glocklueng/I2C-LED/Document/Modification step 2.jpg

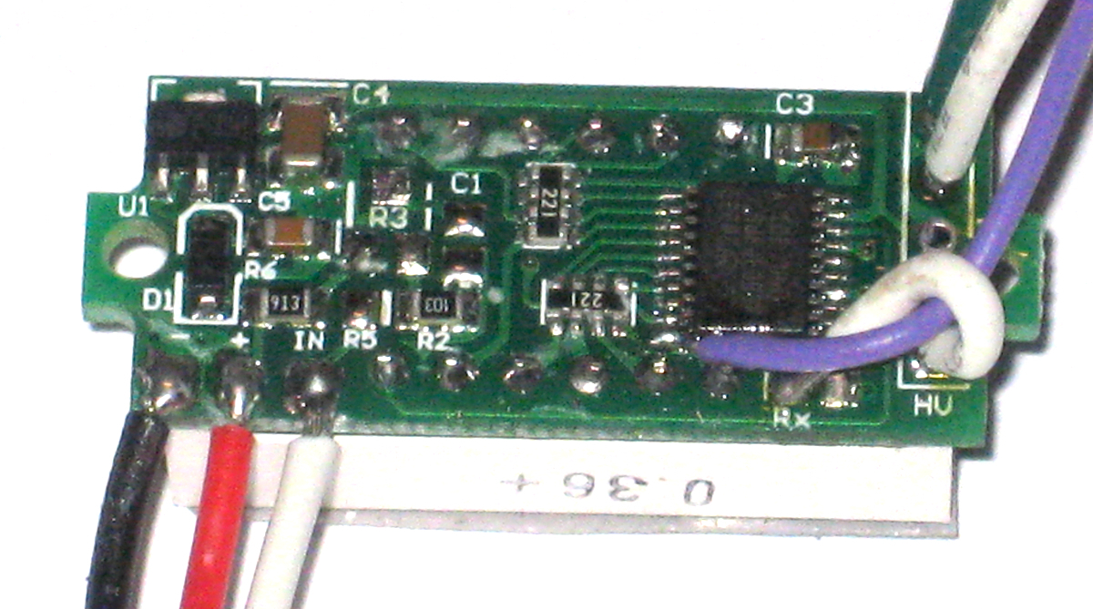
Document/Modification step 2.jpg
