glocklueng/I2C-LED/Document/Original Hardware (front, alternate).jpg

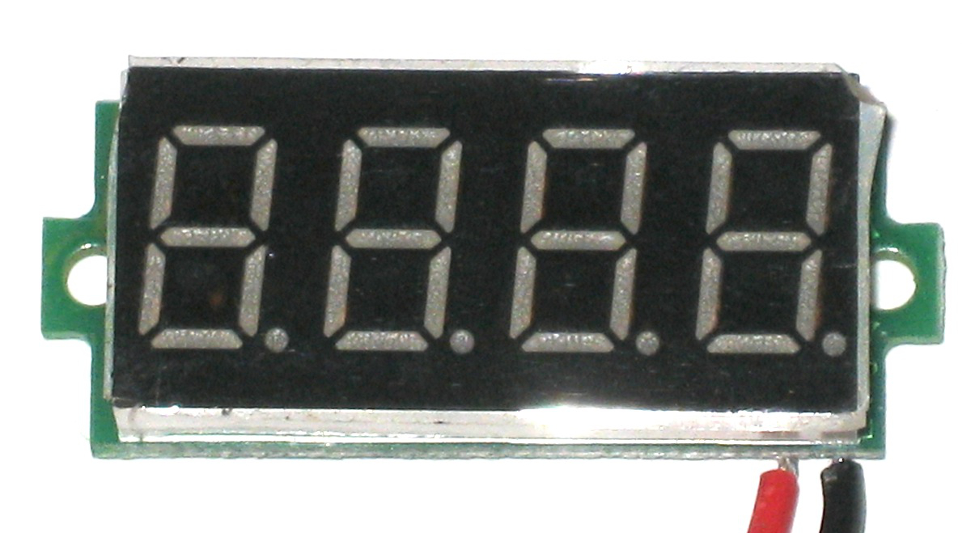
Document/Original Hardware (front, alternate).jpg
