glocklueng/I2C-LED/Document/Modified Hardware.jpg

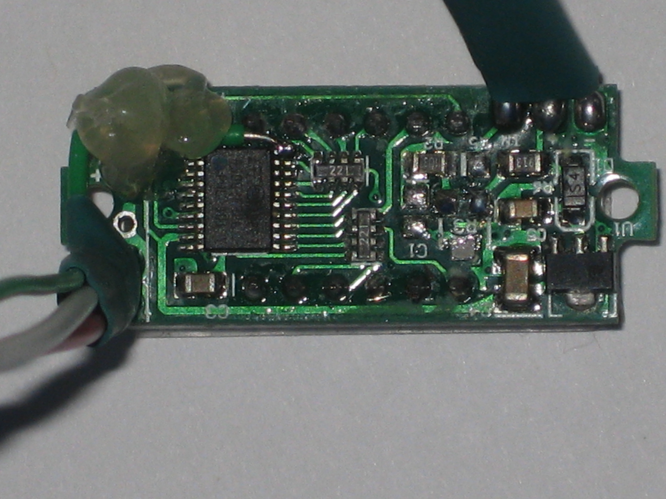
Document/Modified Hardware.jpg
