glocklueng/I2C-LED/Document/Original Hardware (back, type 1).jpg

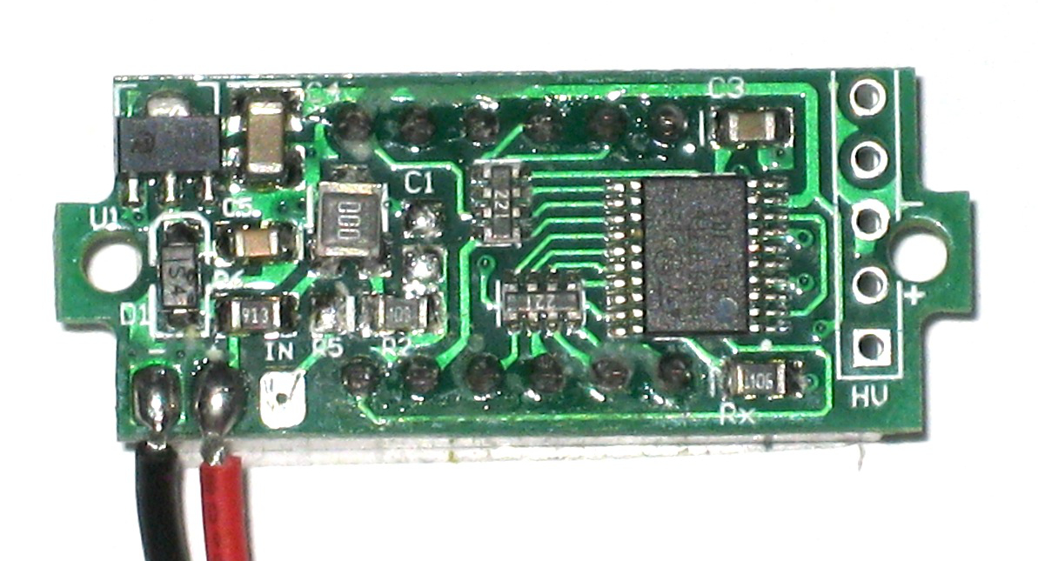
Document/Original Hardware (back, type 1).jpg
