glocklueng/I2C-LED/Document/Original Hardware (back, type 2).jpg

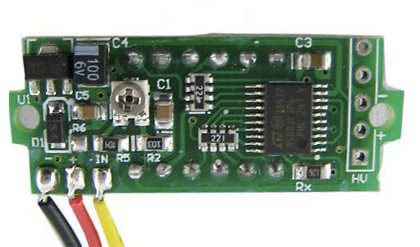
Document/Original Hardware (back, type 2).jpg
