glocklueng/I2C-LED/Document/Original Hardware (front).jpg

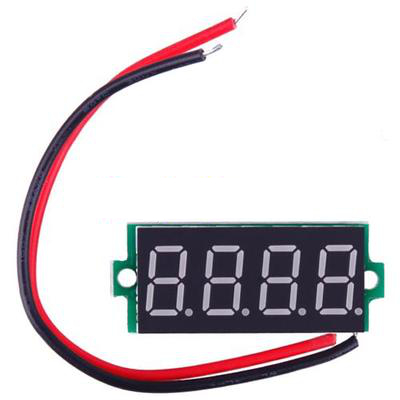
Document/Original Hardware (front).jpg
