glocklueng/I2C-LED/Document/Programming with STM8S discovery.jpg

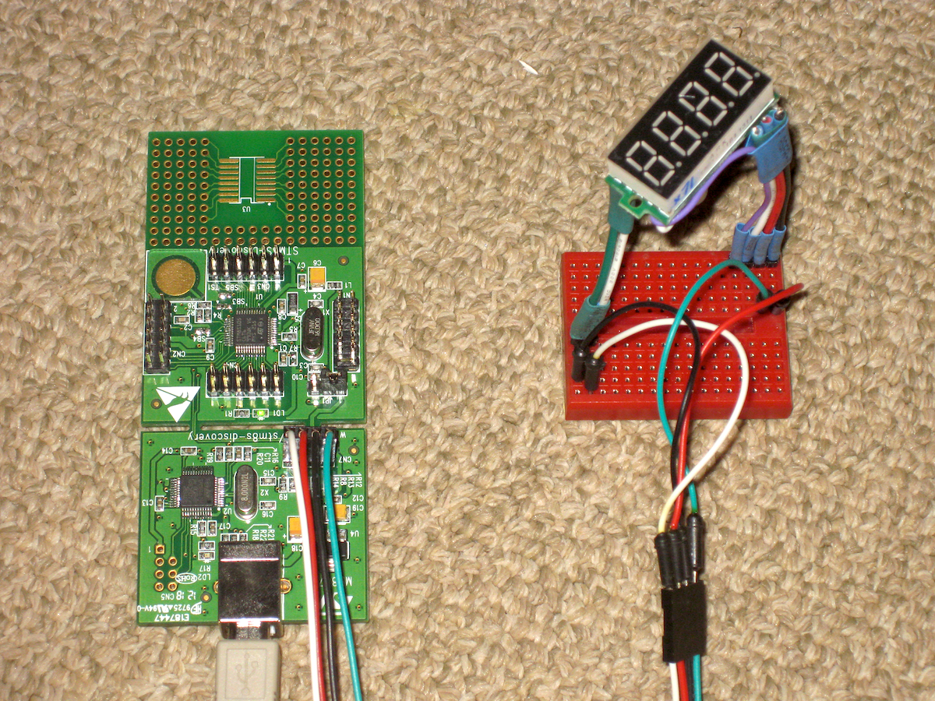
Document/Programming with STM8S discovery.jpg
