glocklueng/I2C-LED/Hardware/voltmeter-hack.png

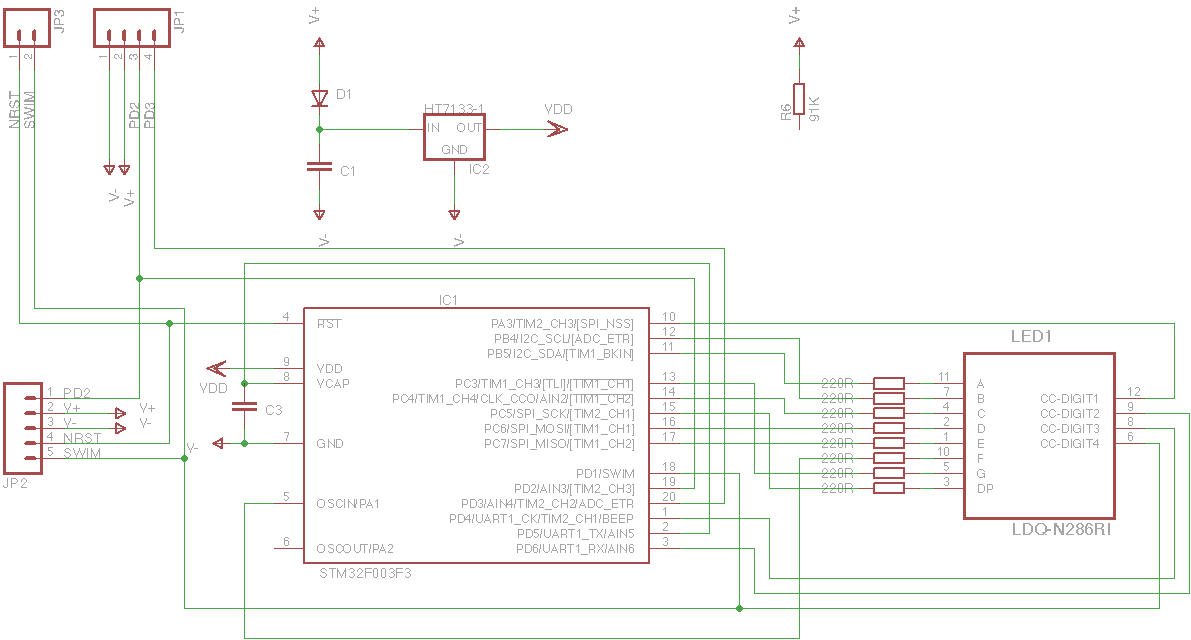
Hardware/voltmeter-hack.png
