glocklueng/I2C-LED/Document/Modification step 1.jpg

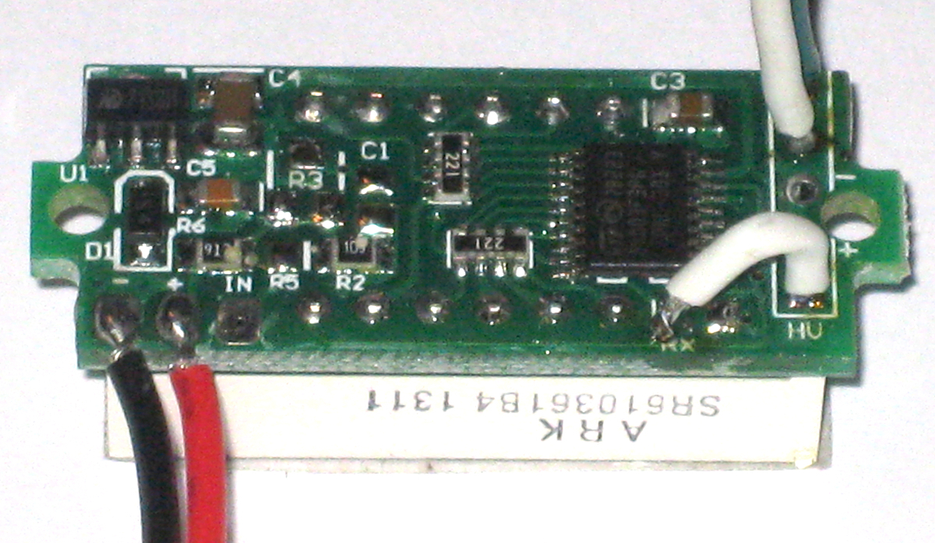
Document/Modification step 1.jpg
