glocklueng/I2C-LED/Document/Modification step 3.jpg

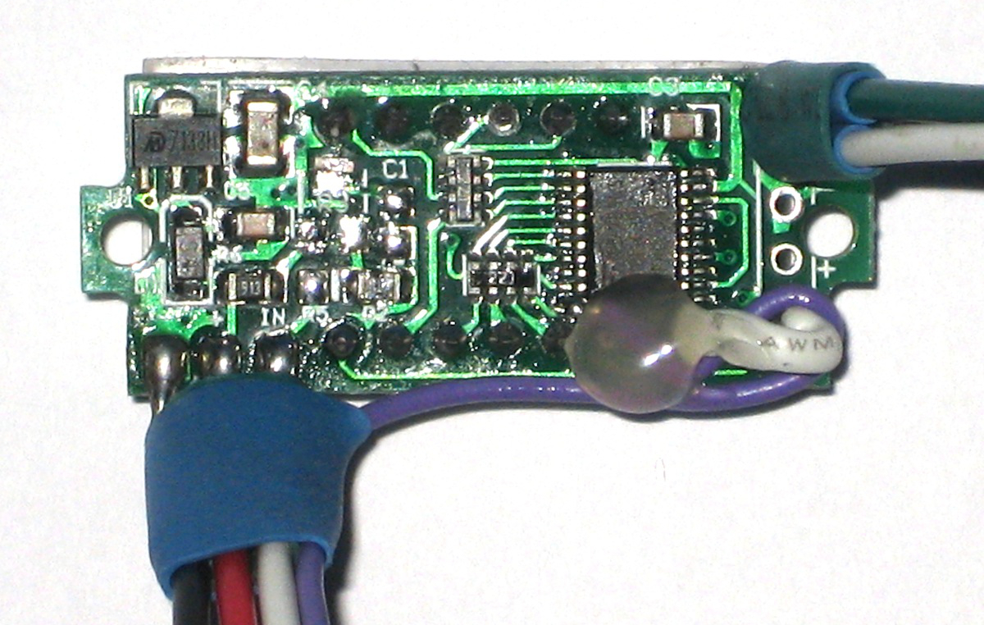
Document/Modification step 3.jpg
