glocklueng/I2C-LED/Document/Arduino Uno running sevenseg_test.ino with multiplexed displays.jpg

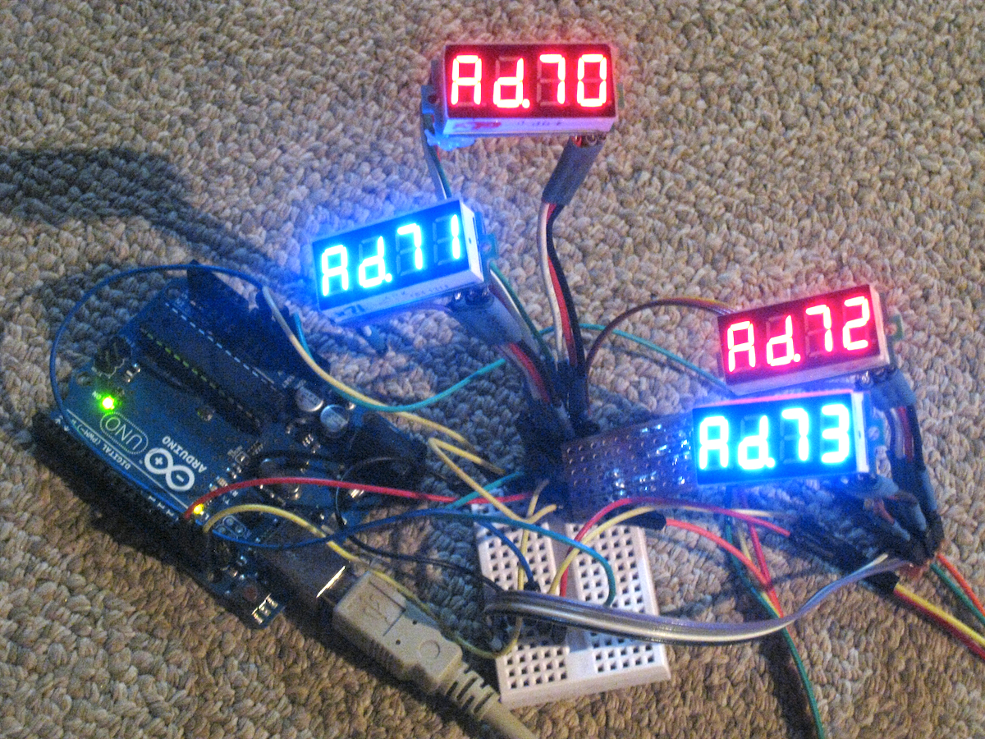
Document/Arduino Uno running sevenseg_test.ino with multiplexed displays.jpg
