glocklueng/I2C-LED/Hardware/voltmeter-hack.sch

## EAGLE design Hardware/voltmeter-hack.sch (2013-09-17)

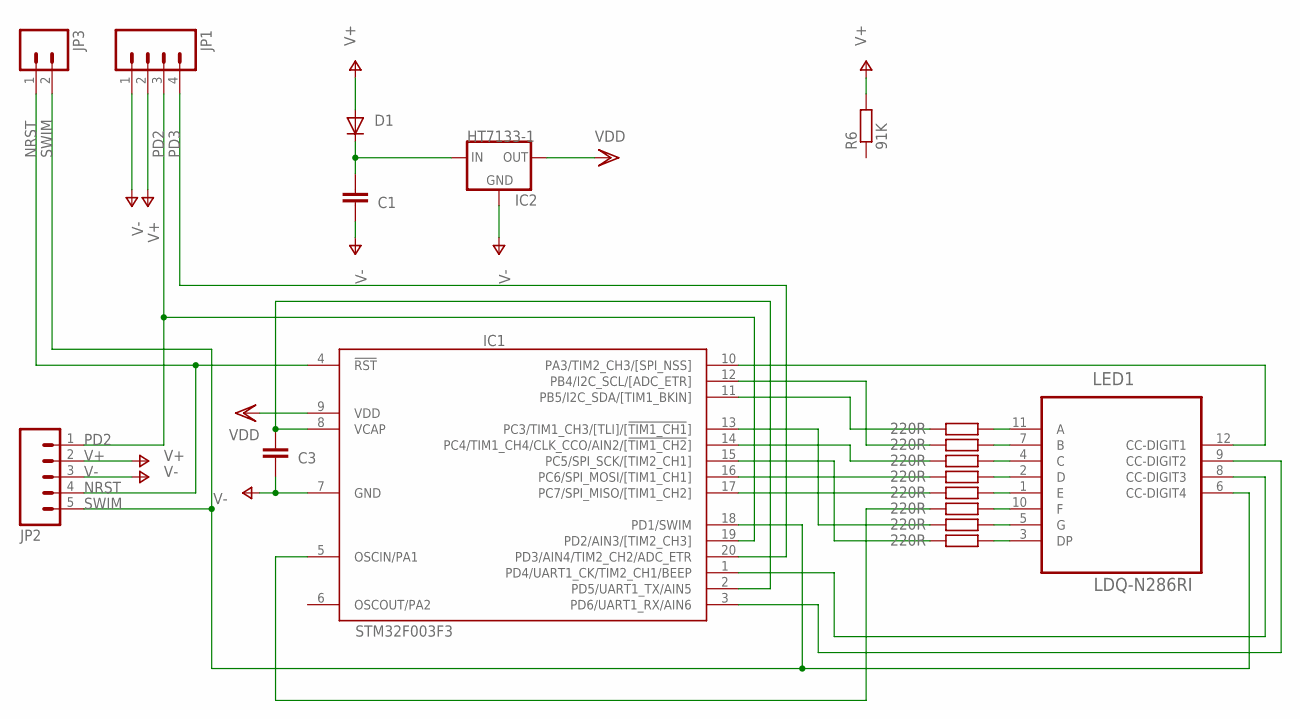
[picture p12: schematic voltmeter-hack.sch]

Parts:
C1, C3: C-EUC0603; C0603
D1: DIODE-SOD-123; SOD-123
IC1: STM32F003F3; TSSOP20
IC2: HT7133-1; SOT89R
JP1: M04PTH; 1X04
JP2: M05PTH; 1X05
JP3: M02PTH; 1X02
LED1: LDQ-N286RI; LUMEX_LDQ-N286RI
R1, R2, R4, R5, R7, R8, R13, R16: 220R; R0603
R6: 91K; R0603

Connections:
unnamed: C1.2, D1.C, IC2.2 (IN)
unnamed: C3.2, IC1.2 (PD5/UART1_TX/AIN5), IC1.8 (VCAP)
unnamed: IC1.10 (PA3/TIM2_CH3/[SPI_NSS]), LED1.12 (CC-DIGIT1)
unnamed: IC1.1 (PD4/UART1_CK/TIM2_CH1/BEEP), LED1.8 (CC-DIGIT3)
unnamed: IC1.3 (PD6/UART1_RX/AIN6), LED1.9 (CC-DIGIT2)
unnamed: LED1.11 (A), R1.2
unnamed: LED1.7 (B), R2.2
unnamed: LED1.4 (C), R13.2
unnamed: LED1.2 (D), R4.2
unnamed: LED1.1 (E), R5.2
unnamed: LED1.10 (F), R16.2
unnamed: LED1.5 (G), R7.2
unnamed: LED1.3 (DP), R8.2
unnamed: IC1.17 (PC7/SPI_MISO/[TIM1_CH2]), R5.1
unnamed: IC1.16 (PC6/SPI_MOSI/[TIM1_CH1]), R4.1
unnamed: IC1.15 (PC5/SPI_SCK/[TIM2_CH1]), R8.1
unnamed: IC1.14 (PC4/TIM1_CH4/CLK_CCO/AIN2/[!TIM1_CH2!]), R13.1
unnamed: IC1.13 (PC3/TIM1_CH3/[TLI]/[!TIM1_CH1!]), R7.1
unnamed: IC1.12 (PB4/I2C_SCL/[ADC_ETR]), R2.1
unnamed: IC1.11 (PB5/I2C_SDA/[TIM1_BKIN]), R1.1
unnamed: IC1.5 (OSCIN/PA1), R16.1
NRST: IC1.4 (!RST), JP2.4, JP3.1
PD2: IC1.19 (PD2/AIN3/[TIM2_CH3]), JP1.3, JP2.1
PD3: IC1.20 (PD3/AIN4/TIM2_CH2/ADC_ETR), JP1.4
SWIM: IC1.18 (PD1/SWIM), JP2.5, JP3.2, LED1.6 (CC-DIGIT4)
V+: D1.A, JP1.2, JP2.2, R6.2
V-: C1.1, C3.1, IC1.7 (GND), IC2.1 (GND), JP1.1, JP2.3
VDD: IC1.9 (VDD), IC2.3 (OUT)
