glocklueng/I2C-LED/(commit log)

2013-08-17 Initial commit of new fork for buyincoins stm8s003 voltmeter hack
    [I2C-LED.sch, voltmeter-hack.sch, voltmeter.sch]
2013-08-22 Update to Eagle schematic
2013-08-23 hacked voltmeter headers
    [voltmeter-hack.sch]
2013-08-24 New photos, schematic .png's
